Abesech-Inbasekar/Tandem_Rotor/Circuit_Diagram.jpg

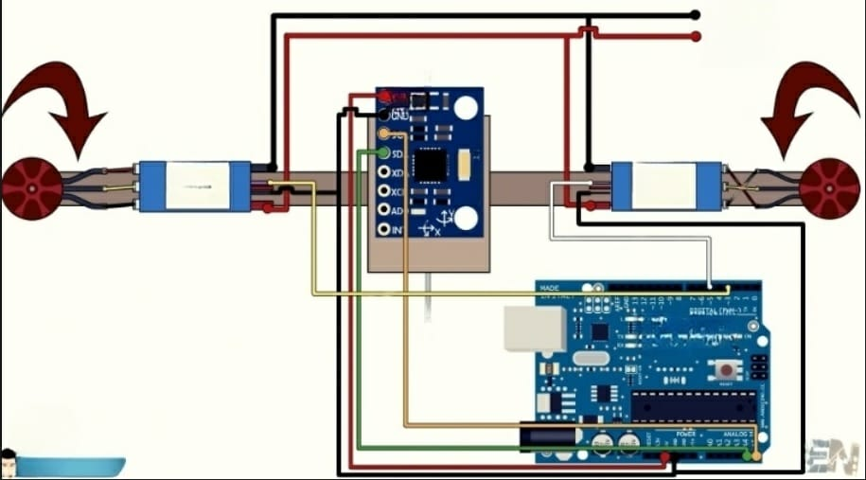
Circuit_Diagram.jpg
