Abesech-Inbasekar/Tandem_Rotor/README.md

# Tandem_Rotor
Built a control algorithm that can balance the pitch of a tandem rotor helicopter by controlling its lift and demonstrated it using a simplified physical setup.

elec
