Abesech-Inbasekar/Tandem_Rotor/Basic_design.png

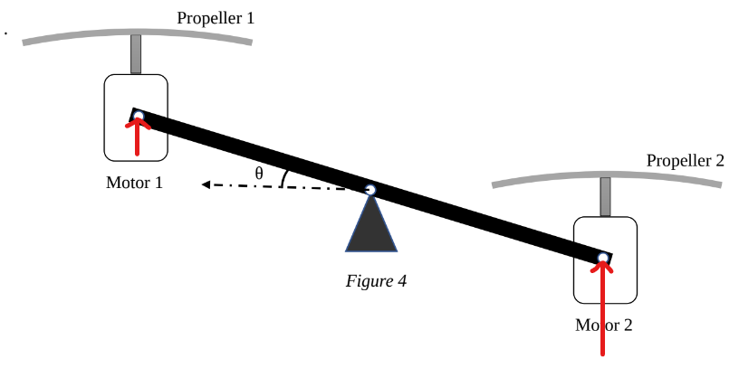
Basic_design.png
