Abesech-Inbasekar/Tandem_Rotor/Chassis_updated v5.step

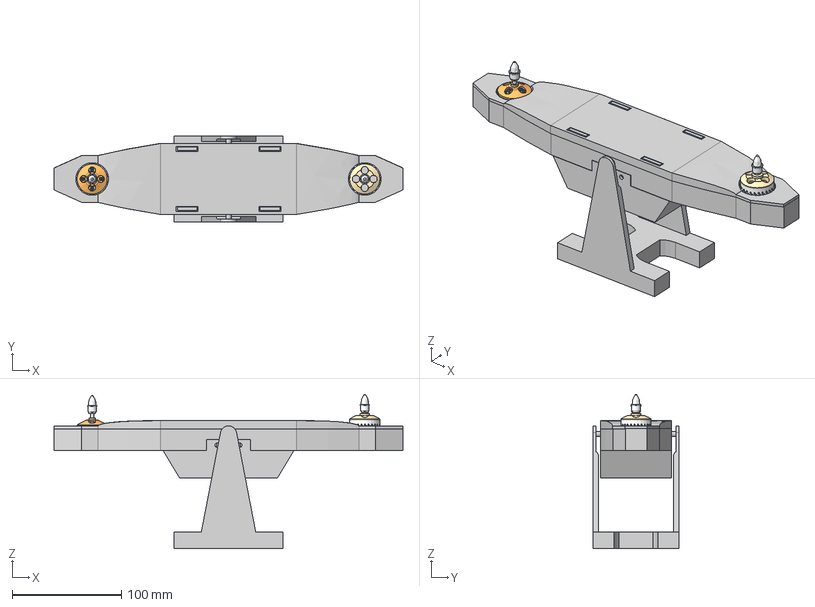
[picture p15: CAD file, 2025-05-22]
Chassis_updated v5.step
320.1 x 78.7 x 141.3 mm
Arduino v1
Chassis EB
MPU 6050
A2212 1000KV Brushless
PRT0001 x 24
Surface 1 x 2
ROTOR1_PRT x 2
bearing_w_639_3-2z_2_3 x 2
bearing_w_639_3-2z_2_4 x 2
bearing_w_639_3-2z_2_1 x 2
bearing_w_639_3-2z_2_5 x 2
bearing_w_639_3-2z_2_2 x 2
Chassis Cover
Pivot
